electrobot-fr/coupe2026/carte_pami/pami.step

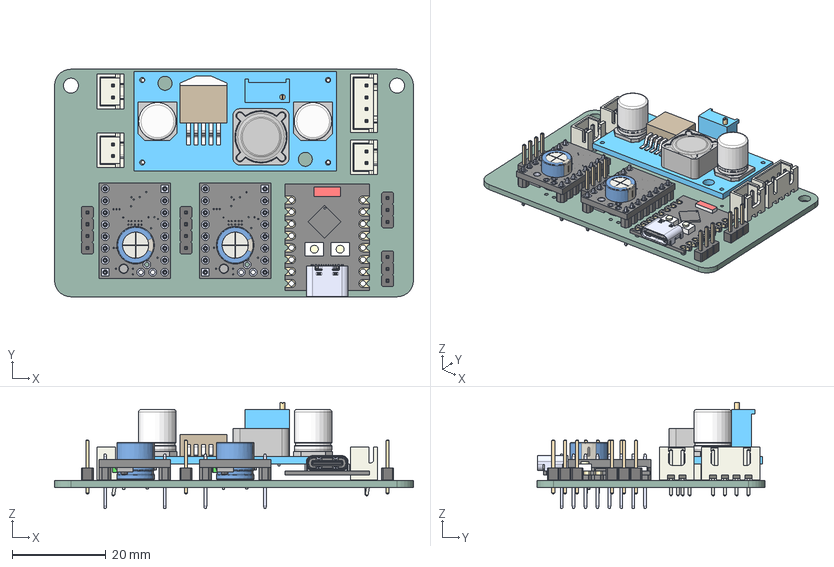
[picture p1: CAD file, 2026-09-27]
carte_pami/pami.step
76.5 x 48.5 x 22.6 mm
CP_Radial_D8.0mm_P5.00mm x 2
PinHeader_1x04_P2.54mm_Vertical x 2
JST_XH_B2B-XH-A_1x02_P2.50mm_Vertical x 3
Board c3mini
USB C
components (other)^ESP32-C3 SuperMini
TMC2209_SILENTSTEPSTICK x 2
PinHeader_1x03_P2.54mm_Vertical x 2
Lm2596
capacitor x 2
LM2596B
Rez3296X
Choke
JST_XH_B4B-XH-A_1x04_P2.50mm_Vertical
pami_PCB
