electrobot-fr/coupe2026/carte_pami/pami.kicad_pcb

## KiCad design carte_pami/pami.kicad_pcb (2026-09-27)

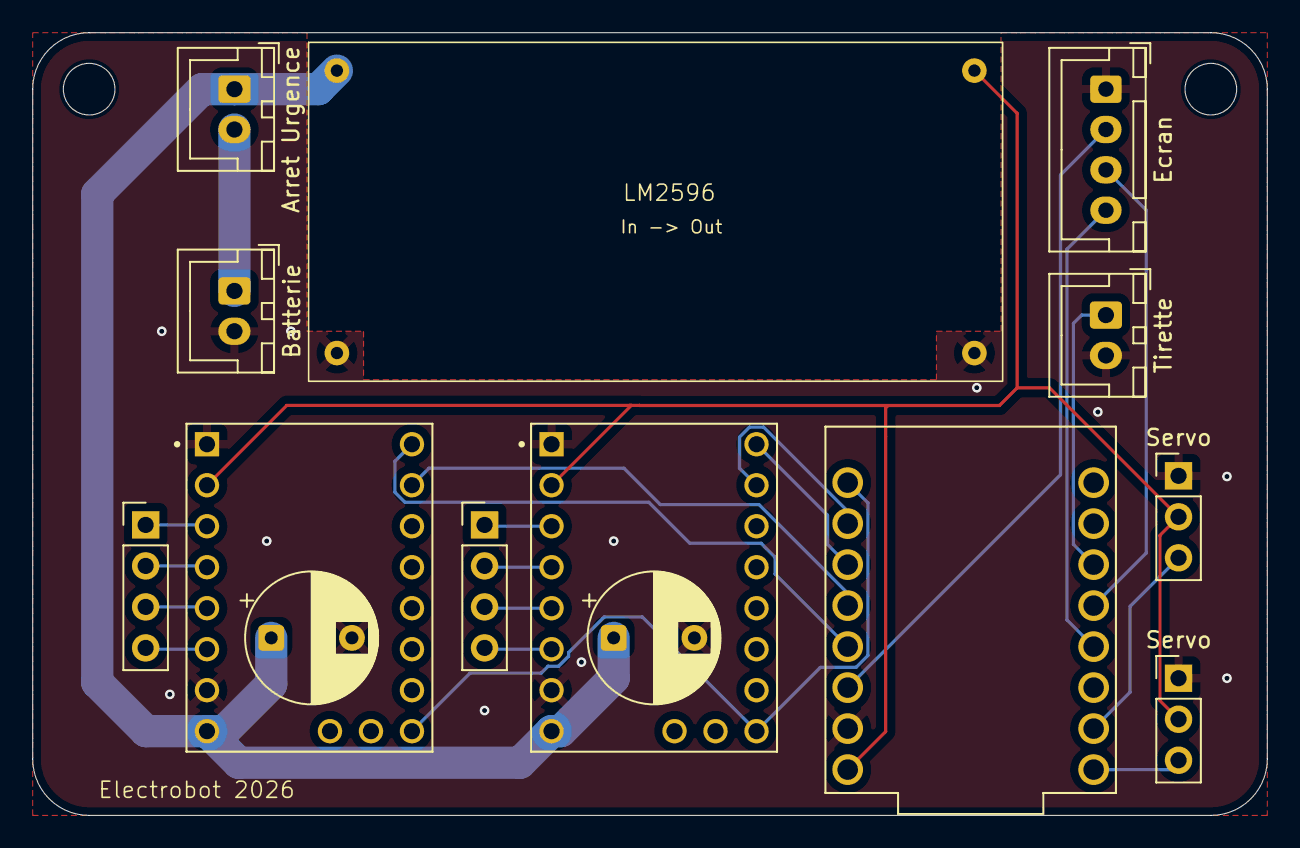
[picture p2: board pami.kicad_pcb from above]

Board: 2 copper layers, 76.5 x 48.5 mm, 16 parts (0 on the bottom side), 23 nets.

Parts:
Arret Urgence: Arret urgence; JST_XH_B2B-XH-A_1x02_P2.50mm_Vertical
Batterie: LP E10 7.4V; JST_XH_B2B-XH-A_1x02_P2.50mm_Vertical
C1, C2: C_Polarized; CP_Radial_D8.0mm_P5.00mm
Ecran: Ecran OLED; JST_XH_B4B-XH-A_1x04_P2.50mm_Vertical
H1, H2: MountingHole; MountingHole_3.2mm_M3
J2: Moteur 1; PinHeader_1x04_P2.54mm_Vertical
J4: Moteur 2; PinHeader_1x04_P2.54mm_Vertical
Servo: Servo; PinHeader_1x03_P2.54mm_Vertical
Servo#2: Servo; PinHeader_1x03_P2.54mm_Vertical
Tirette: Tirette; JST_XH_B2B-XH-A_1x02_P2.50mm_Vertical
U1: ESP32-C3_SUPERMINI_TH; MODULE_ESP32-C3_SUPERMINI
U2: TMC2209 Moteur 1; MODULE_TMC2209_SILENTSTEPSTICK
U3: TMC2209 Moteur 2; MODULE_TMC2209_SILENTSTEPSTICK
VR1: Voltage Regulator; LM2596

Connections:
5V: Servo.2, Servo#2.2, U1.5V, U2.2 (VIO), U3.2 (VIO), VR1.4 (OUT+)
BAT: Arret Urgence.1, C1.1, C2.1, U2.8 (VM), U3.8 (VM), VR1.2 (IN+)
GND: Batterie.2, C1.2, C2.2, Ecran.1, Servo.1, Servo#2.1, Tirette.2, U1.G (GND), U2.1 (GND), U2.7 (GND), U3.1 (GND), U3.7 (GND), VR1.1 (IN-), VR1.3 (OUT-)
unnamed: Ecran.2, U1.3.3 (3V3)
unnamed: Ecran.3, U1.9 (GPIO9)
unnamed: Ecran.4, U1.8 (GPIO8)
unnamed: J2.1, U2.3 (M1B)
unnamed: J2.2, U2.4 (M1A)
unnamed: J2.3, U2.5 (M2A)
unnamed: J2.4, U2.6 (M2B)
unnamed: Arret Urgence.2, Batterie.1
unnamed: J4.1, U3.3 (M1B)
unnamed: J4.2, U3.4 (M1A)
unnamed: J4.3, U3.5 (M2A)
unnamed: J4.4, U3.6 (M2B)
unnamed: Tirette.1, U1.10 (GPIO10)
unnamed: Servo#2.3, U1.5 (GPIO5)
unnamed: Servo.3, U1.6 (GPIO6)
unnamed: U1.0 (GPIO0), U2.16 (~EN), U3.16 (~EN)
unnamed: U1.1 (GPIO1), U3.10 (STEP)
unnamed: U1.2 (GPIO2), U3.9 (DIR)
unnamed: U1.3 (GPIO3), U2.10 (STEP)
unnamed: U1.4 (GPIO4), U2.9 (DIR)
