electrobot-fr/coupe2026/carte_moteurs/carte_moteurs.kicad_pcb

## KiCad design carte_moteurs/carte_moteurs.kicad_pcb (2026-09-27)

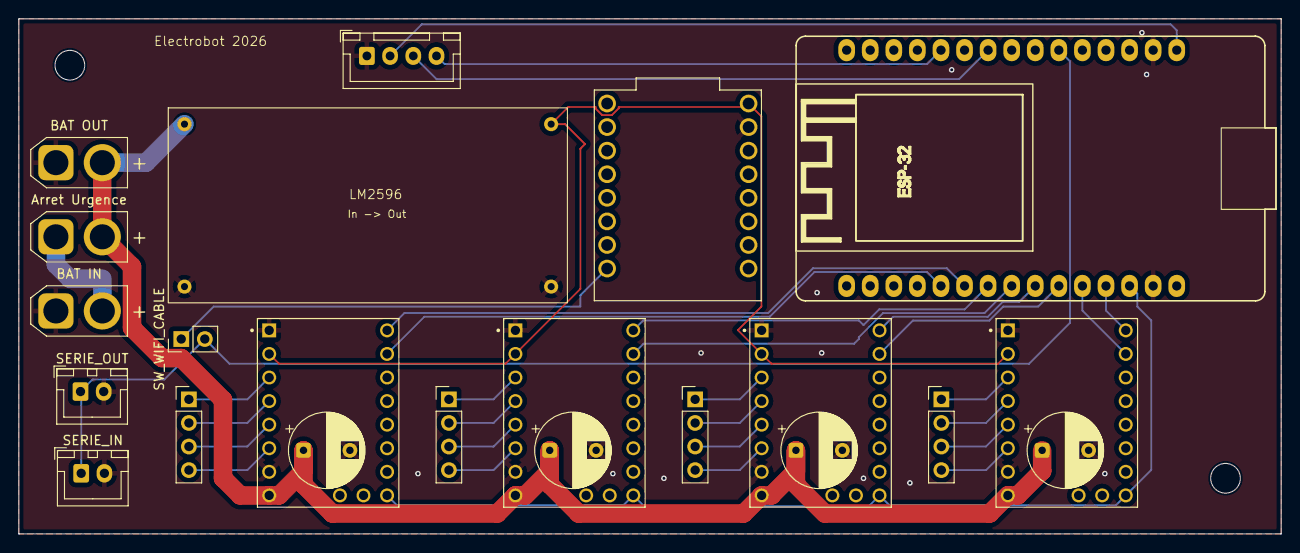
[picture p3: board carte_moteurs.kicad_pcb from above]

Board: 2 copper layers, 136.0 x 55.5 mm, 24 parts (0 on the bottom side), 34 nets.

Parts:
A1: ESP32_DevKit_V1_DOIT_30GPIOs; DOIT_ESP32_DEVKIT_30Pins
Arret Urgence: Arret urgence; AMASS_XT30U-F_1x02_P5.0mm_Vertical
BAT IN: BAT_IN; AMASS_XT30U-F_1x02_P5.0mm_Vertical
BAT OUT: Conn_01x02_Socket; AMASS_XT30U-F_1x02_P5.0mm_Vertical
C1, C2, C3, C4: C_Polarized; CP_Radial_D8.0mm_P5.00mm
H1, H2: MountingHole; MountingHole_3.2mm_M3
J1: Ecran OLED; JST_XH_B4B-XH-A_1x04_P2.50mm_Vertical
J2: Moteur 1; PinHeader_1x04_P2.54mm_Vertical
J4: Moteur 2; PinHeader_1x04_P2.54mm_Vertical
J9: Moteur 4; PinHeader_1x04_P2.54mm_Vertical
J10: Moteur 3; PinHeader_1x04_P2.54mm_Vertical
SERIE_IN: Conn_01x02_Socket; JST_XH_B2B-XH-A_1x02_P2.50mm_Vertical
SERIE_OUT: Conn_01x02_Socket; JST_XH_B2B-XH-A_1x02_P2.50mm_Vertical
SW_WIFI_CABLE: Conn_01x02_Socket; PinHeader_1x02_P2.54mm_Vertical
U1: ESP32-C3_SUPERMINI_TH; MODULE_ESP32-C3_SUPERMINI
U2: TMC2209 Moteur 1; MODULE_TMC2209_SILENTSTEPSTICK
U3: TMC2209 Moteur 2; MODULE_TMC2209_SILENTSTEPSTICK
U4: TMC2209 Moteur 4; MODULE_TMC2209_SILENTSTEPSTICK
U5: TMC2209 Moteur 3; MODULE_TMC2209_SILENTSTEPSTICK
VR1: Voltage Regulator; LM2596

Connections:
5V: U1.5V, U2.2 (VIO), U3.2 (VIO), U4.2 (VIO), U5.2 (VIO), VR1.4 (OUT+)
/3V3: A1.1 (3.3V), J1.2
/DIR_M1: A1.21 (ADC1_CH4/D32), U2.9 (DIR)
/DIR_M2: A1.22 (ADC1_CH4/D32), U3.9 (DIR)
/DIR_M3: A1.27 (ADC2_CH5/D12), U5.9 (DIR)
/DIR_M4: A1.24 (DAC2/ADC2_CH9/D26), U4.9 (DIR)
/ESP_WIFI_TX: SW_WIFI_CABLE.1, U1.21 (GPIO21)
/OLED_SCK: A1.9 (D18), J1.3
/OLED_SDA: A1.11 (D21/SDA), J1.4
/STEP_M1: A1.20 (ADC1_CH7/D35), U2.10 (STEP)
/STEP_M2: A1.23 (DAC1/ADC2_CH8/D25), U3.10 (STEP)
/STEP_M3: A1.26 (ADC2_CH6/D14), U5.10 (STEP)
/STEP_M4: A1.25 (ADC2_CH7/D27), U4.10 (STEP)
/WROOM_RX: A1.6 (RX2/GPIO16), SERIE_IN.1, SERIE_OUT.1, SW_WIFI_CABLE.2
BAT: Arret Urgence.2, BAT OUT.2, C1.1, C2.1, C3.1, C4.1, U2.8 (VM), U3.8 (VM), U4.8 (VM), U5.8 (VM), VR1.2 (IN+)
EN: A1.28 (ADC2_CH4/D13), U2.16 (~EN), U3.16 (~EN), U4.16 (~EN), U5.16 (~EN)
GND: A1.2 (GND), A1.29 (GND), BAT IN.1, BAT OUT.1, C1.2, C2.2, C3.2, C4.2, J1.1, SERIE_IN.2, SERIE_OUT.2, U1.G (GND), U2.1 (GND), U2.7 (GND), U3.1 (GND), U3.7 (GND), U4.1 (GND), U4.7 (GND), U5.1 (GND), U5.7 (GND), VR1.1 (IN-), VR1.3 (OUT-)
unnamed: Arret Urgence.1, BAT IN.2
unnamed: J2.1, U2.3 (M1B)
unnamed: J2.2, U2.4 (M1A)
unnamed: J2.3, U2.5 (M2A)
unnamed: J2.4, U2.6 (M2B)
unnamed: J4.1, U3.3 (M1B)
unnamed: J4.2, U3.4 (M1A)
unnamed: J4.3, U3.5 (M2A)
unnamed: J4.4, U3.6 (M2B)
unnamed: J9.1, U4.3 (M1B)
unnamed: J9.2, U4.4 (M1A)
unnamed: J9.3, U4.5 (M2A)
unnamed: J9.4, U4.6 (M2B)
unnamed: J10.1, U5.3 (M1B)
unnamed: J10.2, U5.4 (M1A)
unnamed: J10.3, U5.5 (M2A)
unnamed: J10.4, U5.6 (M2B)
