electrobot-fr/coupe2026/(commit log)

2025-11-08 mise a jour de l'indentation
2025-11-17 ajout servo et tirette
2025-11-22 tirette, déplacement des steppers en distance en mm et servomoteur à l afin du parcours
2025-12-23 LED status
2025-12-27 Toutes les directions
2026-01-01 Ajout de l'ecureuil
2026-02-14 V1 : prise en compte de tous les composants
2026-03-22 Ajout de l UI
2026-03-22 Strategie de base
2026-03-23 Seance de dimanche
2026-03-23 Timing pour les vannes
2026-04-04 mise à jour du déplacement des 4 PAMI
2026-04-22 Réglages des PAMI pour la coupe 2026
2026-09-27 add KiCad projects carte_moteurs and carte_pami with gitignore
